lowprocess/carrier/bak/carrier.kicad_pcb

## KiCad design bak/carrier.kicad_pcb (2026-10-01)

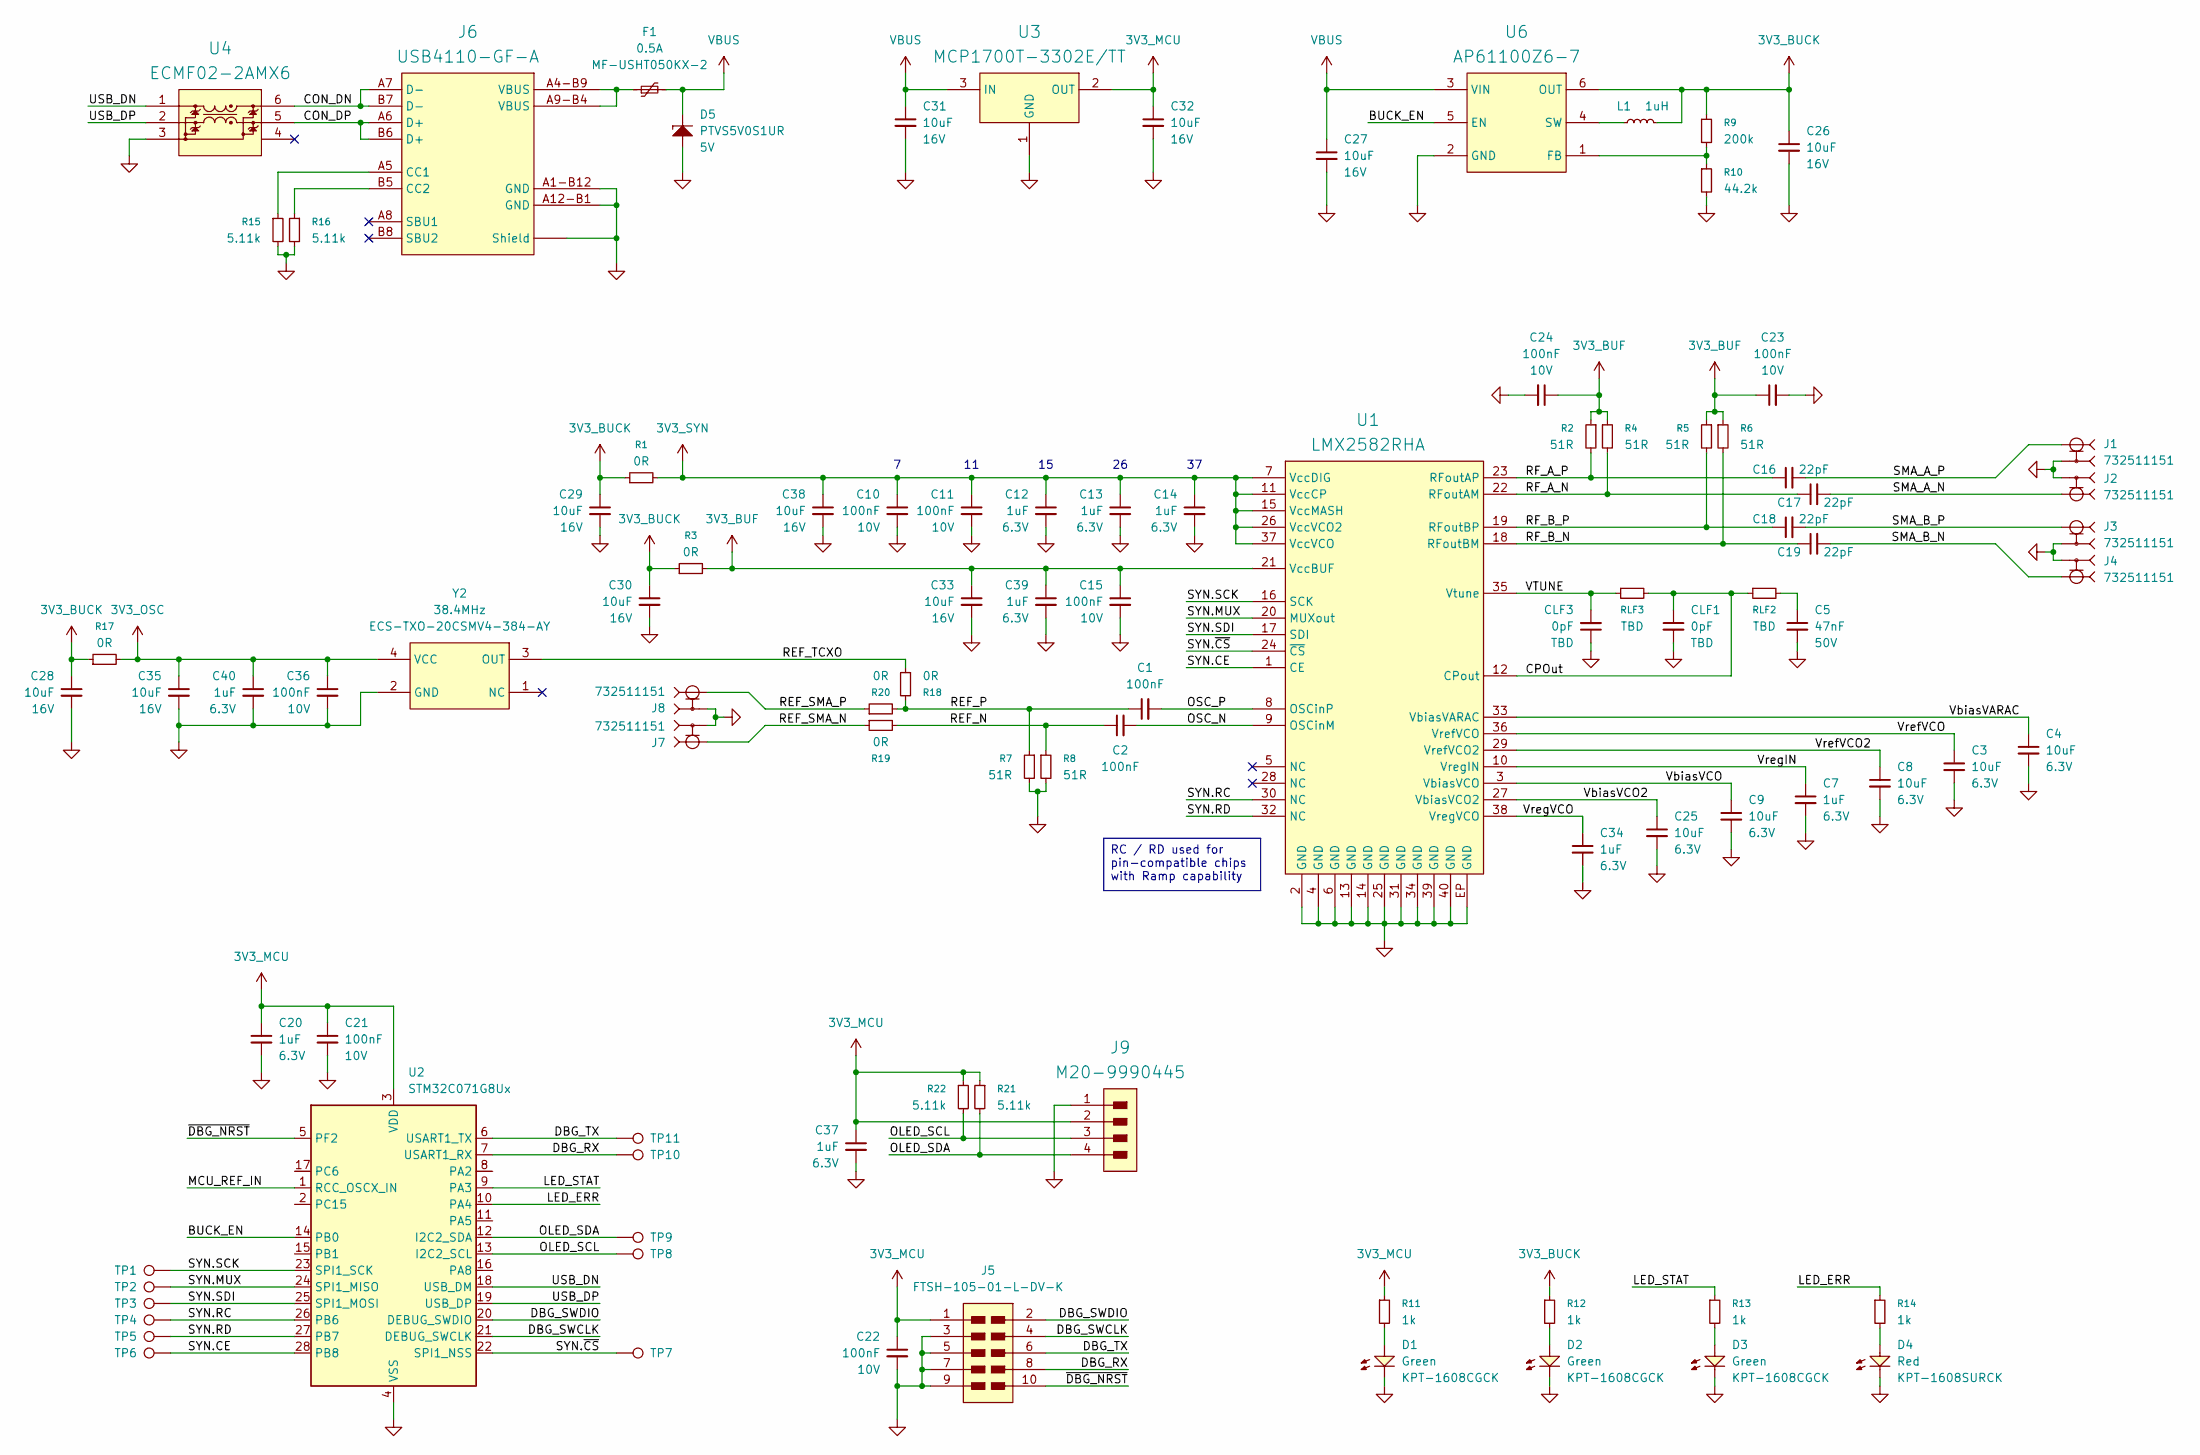
[picture p1: schematic carrier.kicad_sch]

Parts:
C1, C2, C10, C11, C15, C21, C22, C23, C24, C36: 100nF; C_0402; Tolerance 10%; Voltage 10V; PartNumber GRM155R71A104K
C3, C4, C8, C9, C25: 10uF; C_0402; Tolerance 20%; Voltage 6.3V; PartNumber GRM155R60J106M
C5: 47nF; C_1206; Tolerance 5%; Voltage 50V; PartNumber C1206C473J5GACTU
C7, C12, C13, C14, C20, C34, C37, C39, C40: 1uF; C_0402; Tolerance 10%; Voltage 6.3V; PartNumber GRM155R70J105K
C16, C17, C18, C19: 22pF; C_0201; Tolerance 5%; Voltage 25V; PartNumber GRM0335C1E220J
C26, C27, C28, C29, C30, C31, C32, C33, C35, C38: 10uF; C_0805; Tolerance 10%; Voltage 16V; PartNumber GRM21BR61C106K
CLF1, CLF3: 0pF; C_0402; Tolerance TBD; Voltage TBD; PartNumber 0402_TBD
D1, D2, D3: Green; LED_0603; PartNumber KPT-1608CGCK
D4: Red; LED_0603; PartNumber KPT-1608SURCK
D5: SOD123W; PartNumber PTVS5V0S1UR
F1: 0.5A; F_1210; PartNumber MF-USHT050KX-2
J1, J2, J3, J4, J7, J8: 732511151; Molex 73251-1151; PartNumber 732511151
J5: FTSH-105-01-L-DV-K; FTSH-105-01-X-DV-K; PartNumber FTSH-105-01-L-DV-K
J6: USB4110-GF-A; USB-C USB4110; PartNumber USB4110-GF-A
J9: M20-9990445; Header 2.54 1x04 Staggered; PartNumber M20-9990445
L1: 1uH; L_252010; Tolerance 20%; PartNumber CIGT252010EH1R0MNE
R1, R3, R17, R18, R19, R20: 0R; R_0402; Tolerance 0%; PartNumber CRCW04020000Z0ED
R2, R4, R5, R6, R7, R8: 51R; R_0201; Tolerance 1%; PartNumber CRCW020151R0FNED
R9: 200k; R_0402; Tolerance 1%; PartNumber RC0402FR-07200KL
R10: 44.2k; R_0402; Tolerance 1%; PartNumber RC0402FR-0744K2L
R11, R12, R13, R14: 1k; R_0402; Tolerance 1%; PartNumber CRCW04021K00FKED
R15, R16, R21, R22: 5.11k; R_0402; Tolerance 1%; PartNumber RC0402FR-075K11L
RLF2, RLF3: TBD; R_0402; Tolerance TBD; PartNumber 0402_TBD
TP1: SCK; Testpad_1mm
TP2: MUX; Testpad_1mm
TP3: SDI; Testpad_1mm
TP4: RC; Testpad_1mm
TP5: RD; Testpad_1mm
TP6: CE; Testpad_1mm
TP7: CS; Testpad_1mm
TP8: SCL; Testpad_1mm
TP9, TP10, TP11: SDA; Testpad_1mm
U1: QFN40; PartNumber LMX2582RHA
U2: STM32C071G8Ux; QFN-28_4x4mm_P0.5mm
U3: SOT-23-3; PartNumber MCP1700T-3302E/TT
U4: DFN6-1.55x1.75; PartNumber ECMF02-2AMX6
U6: SOT563; PartNumber AP61100Z6-7
Y2: 38.4MHz; XTAL2016-4; PartNumber ECS-TXO-20CSMV4-384-AY

Connections:
3V3_BUCK: C26.1, C28.1, C29.1, C30.1, L1.2, R1.1, R3.1, R9.1, R12.1, R17.1, U6.6 (OUT)
3V3_BUF: C15.1, C23.1, C24.1, C33.1, C39.1, R2.1, R3.2, R4.1, R5.1, R6.1, U1.21 (VccBUF)
3V3_MCU: C20.1, C21.1, C22.1, C32.1, C37.1, J5.1, J9.2, R11.1, R21.1, R22.1, U2.3 (VDD), U3.2 (OUT)
3V3_OSC: C35.1, C36.1, C40.1, R17.2, Y2.4 (VCC)
3V3_SYN: C10.1, C11.1, C12.1, C13.1, C14.1, C38.1, R1.2, U1.7 (VccDIG), U1.11 (VccCP), U1.15 (VccMASH), U1.26 (VccVCO2), U1.37 (VccVCO)
/BUCK_EN: U2.14 (PB0), U6.5 (EN)
/CON_DN: J6.A7 (D-), J6.B7 (D-), U4.6 (IC+)
/CON_DP: J6.A6 (D+), J6.B6 (D+), U4.5 (IC-)
/CPOut: CLF1.1, RLF2.1, RLF3.2, U1.12 (CPout)
/DBG_RX: J5.8, TP10.1 (1_1), U2.7 (USART1_RX)
/DBG_SWCLK: J5.4, U2.21 (DEBUG_SWCLK)
/DBG_SWDIO: J5.2, U2.20 (DEBUG_SWDIO)
/DBG_TX: J5.6, TP11.1 (1_1), U2.6 (USART1_TX)
/LED_ERR: R14.1, U2.10 (PA4)
/LED_STAT: R13.1, U2.9 (PA3)
/MCU_REF_IN: U2.1 (RCC_OSCX_IN)
/OLED_SCL: J9.3, R22.2, TP8.1 (1_1), U2.13 (I2C2_SCL)
/OLED_SDA: J9.4, R21.2, TP9.1 (1_1), U2.12 (I2C2_SDA)
/OSC_N: C2.2, U1.9 (OSCinM)
/OSC_P: C1.2, U1.8 (OSCinP)
/REF_N: C2.1, R8.1, R19.2
/REF_P: C1.1, R7.1, R18.2, R20.2
/REF_SMA_N: J7.inner (Inner), R19.1
/REF_SMA_P: J8.inner (Inner), R20.1
/REF_TCXO: R18.1, Y2.3 (OUT)
/RF_A_N: C17.1, R4.2, U1.22 (RFoutAM)
/RF_A_P: C16.1, R2.2, U1.23 (RFoutAP)
/RF_B_N: C19.1, R6.2, U1.18 (RFoutBM)
/RF_B_P: C18.1, R5.2, U1.19 (RFoutBP)
/SMA_A_N: C17.2, J2.inner (Inner)
/SMA_A_P: C16.2, J1.inner (Inner)
/SMA_B_N: C19.2, J4.inner (Inner)
/SMA_B_P: C18.2, J3.inner (Inner)
/SYN.CE: TP6.1 (1_1), U1.1 (CE), U2.28 (PB8)
/SYN.MUX: TP2.1 (1_1), U1.20 (MUXout), U2.24 (SPI1_MISO)
/SYN.RC: TP4.1 (1_1), U1.30 (NC), U2.26 (PB6)
/SYN.RD: TP5.1 (1_1), U1.32 (NC), U2.27 (PB7)
/SYN.SCK: TP1.1 (1_1), U1.16 (SCK), U2.23 (SPI1_SCK)
/SYN.SDI: TP3.1 (1_1), U1.17 (SDI), U2.25 (SPI1_MOSI)
/SYN.~CS: TP7.1 (1_1), U1.24 (~CS), U2.22 (SPI1_NSS)
/USB_DN: U2.18 (USB_DM), U4.1 (CON+)
/USB_DP: U2.19 (USB_DP), U4.2 (CON-)
/VTUNE: CLF3.2, RLF3.1, U1.35 (Vtune)
/VbiasVARAC: C4.1, U1.33 (VbiasVARAC)
/VbiasVCO: C9.1, U1.3 (VbiasVCO)
/VbiasVCO2: C25.1, U1.27 (VbiasVCO2)
/VrefVCO: C3.1, U1.36 (VrefVCO)
/VrefVCO2: C8.1, U1.29 (VrefVCO2)
/VregIN: C7.1, U1.10 (VregIN)
/VregVCO: C34.1, U1.38 (VregVCO)
/~DBG_NRST: J5.10, U2.5 (PF2)
GND: C3.2, C4.2, C5.2, C7.2, C8.2, C9.2, C10.2, C11.2, C12.2, C13.2, C14.2, C15.2, C20.2, C21.2, C22.2, C23.2, C24.2, C25.2, C26.2, C27.2, C28.2, C29.2, C30.2, C31.2, C32.2, C33.2, C34.2, C35.2, C36.2, C37.2, C38.2, C39.2, C40.2, CLF1.2, CLF3.1, D1.K, D2.K, D3.K, D4.K, D5.A, J1.outer (Outer), J2.outer (Outer), J3.outer (Outer), J4.outer (Outer), J5.3, J5.5, J5.7, J5.9, J6.A1-B12 (GND), J6.A12-B1 (GND), J6.SH (Shield), J7.outer (Outer), J8.outer (Outer), J9.1, R7.2, R8.2, R10.2, R15.2, R16.2, U1.2 (GND), U1.4 (GND), U1.6 (GND), U1.13 (GND), U1.14 (GND), U1.25 (GND), U1.31 (GND), U1.34 (GND), U1.39 (GND), U1.40 (GND), U1.EP (GND), U2.4 (VSS), U3.1 (GND), U4.3 (GND), U6.2 (GND), Y2.2 (GND); also elsewhere on the board
unnamed 52: C5.1, RLF2.2; also elsewhere on the board
unnamed: D1.A, R11.2
unnamed: D2.A, R12.2
unnamed: D3.A, R13.2
unnamed: D4.A, R14.2
unnamed: F1.1, J6.A4-B9 (VBUS), J6.A9-B4 (VBUS)
unnamed: J6.A5 (CC1), R15.1
unnamed: J6.B5 (CC2), R16.1
unnamed: R9.2, R10.1, U6.1 (FB)
unnamed: L1.1, U6.4 (SW)
VBUS: C27.1, C31.1, D5.K, F1.2, U3.3 (IN), U6.3 (VIN)

Notes on the sheet:
RC / RD used for pin-compatible chips with Ramp capability

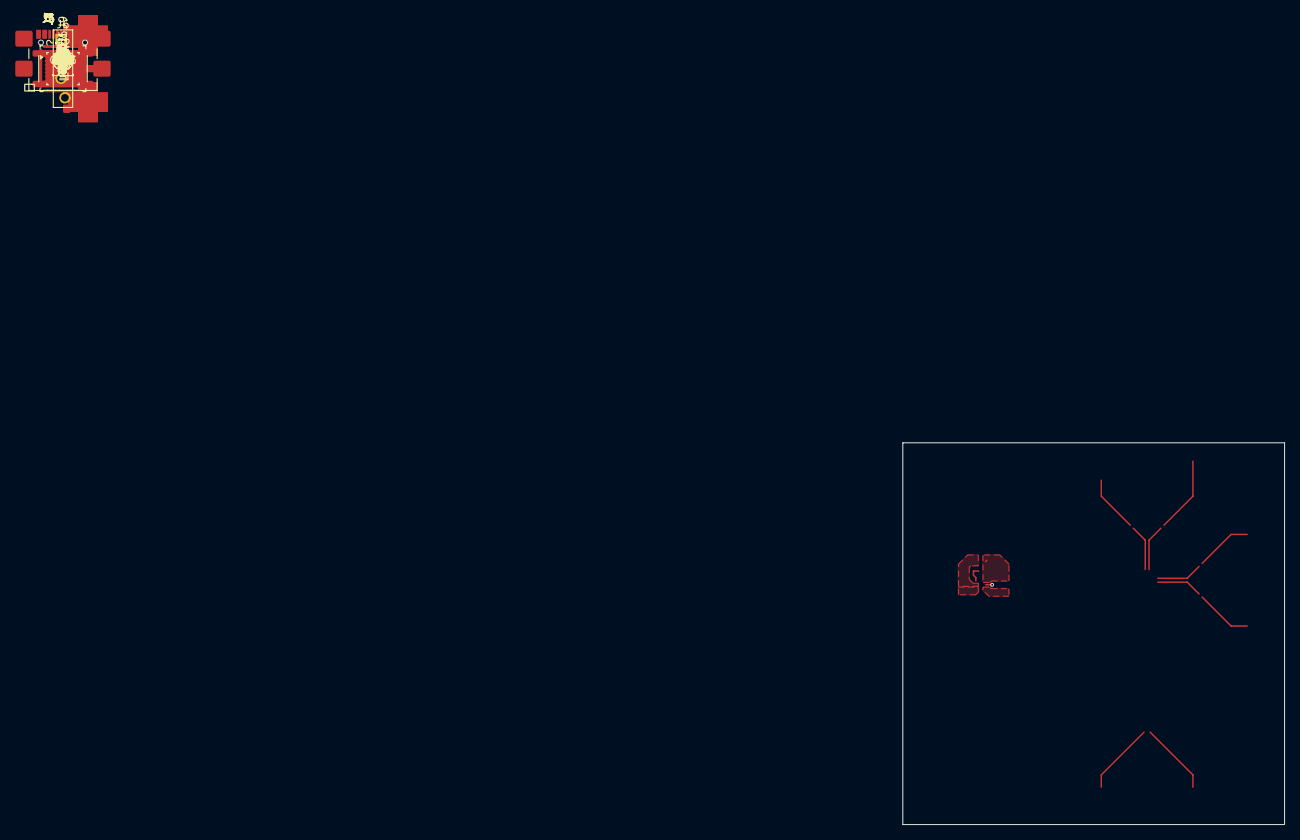
[picture p2: board bak/carrier.kicad_pcb from above]

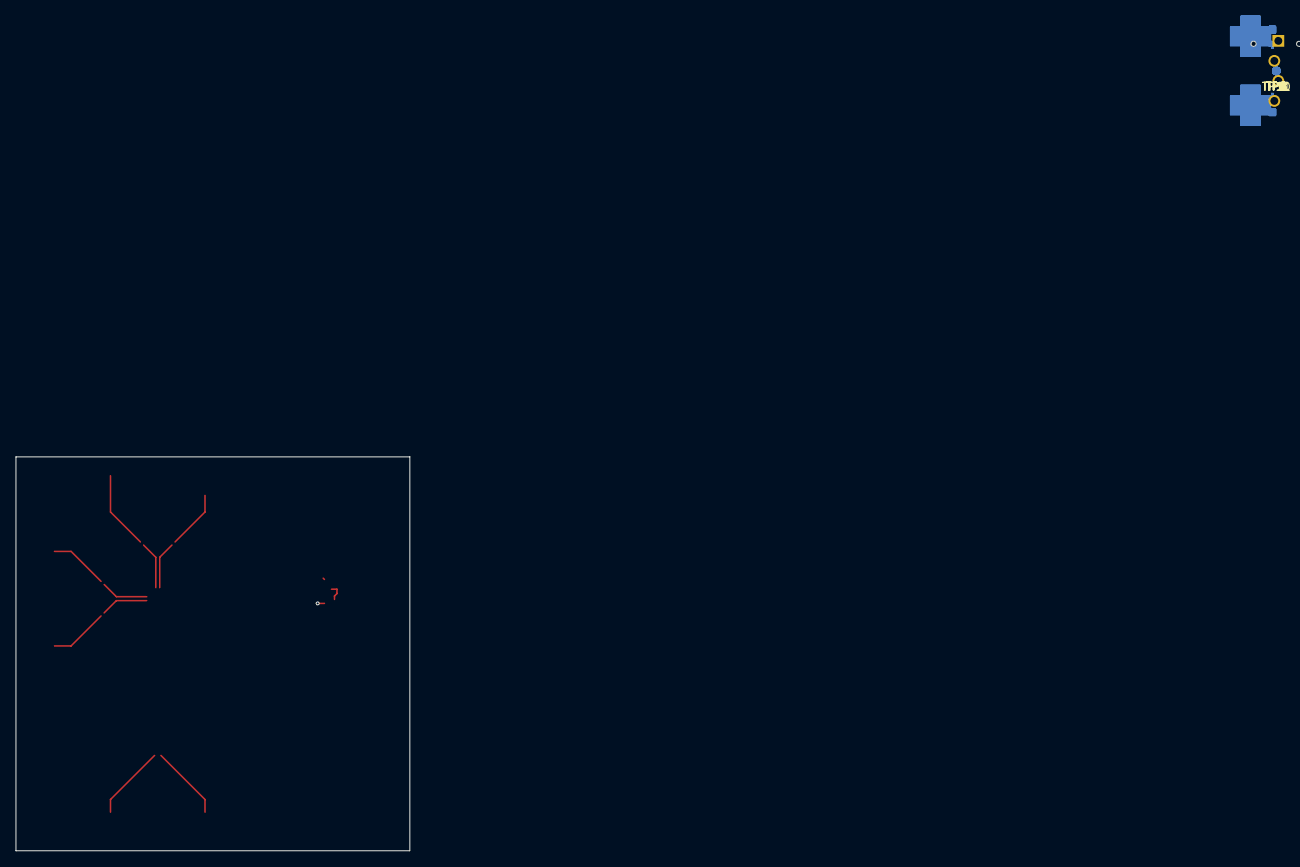
[picture p3: board bak/carrier.kicad_pcb from below]

Board: 2 copper layers, 50.0 x 50.0 mm, 98 parts (11 on the bottom side), 62 nets.

Other parts of the board:
CLF2: 0pF; C_0402

Their connections:
GND: CLF2.2; also elsewhere on the board
unnamed 52: CLF2.1; also elsewhere on the board
