lowprocess/carrier/carrier.kicad_pcb

## KiCad design carrier.kicad_pcb (2026-10-01)

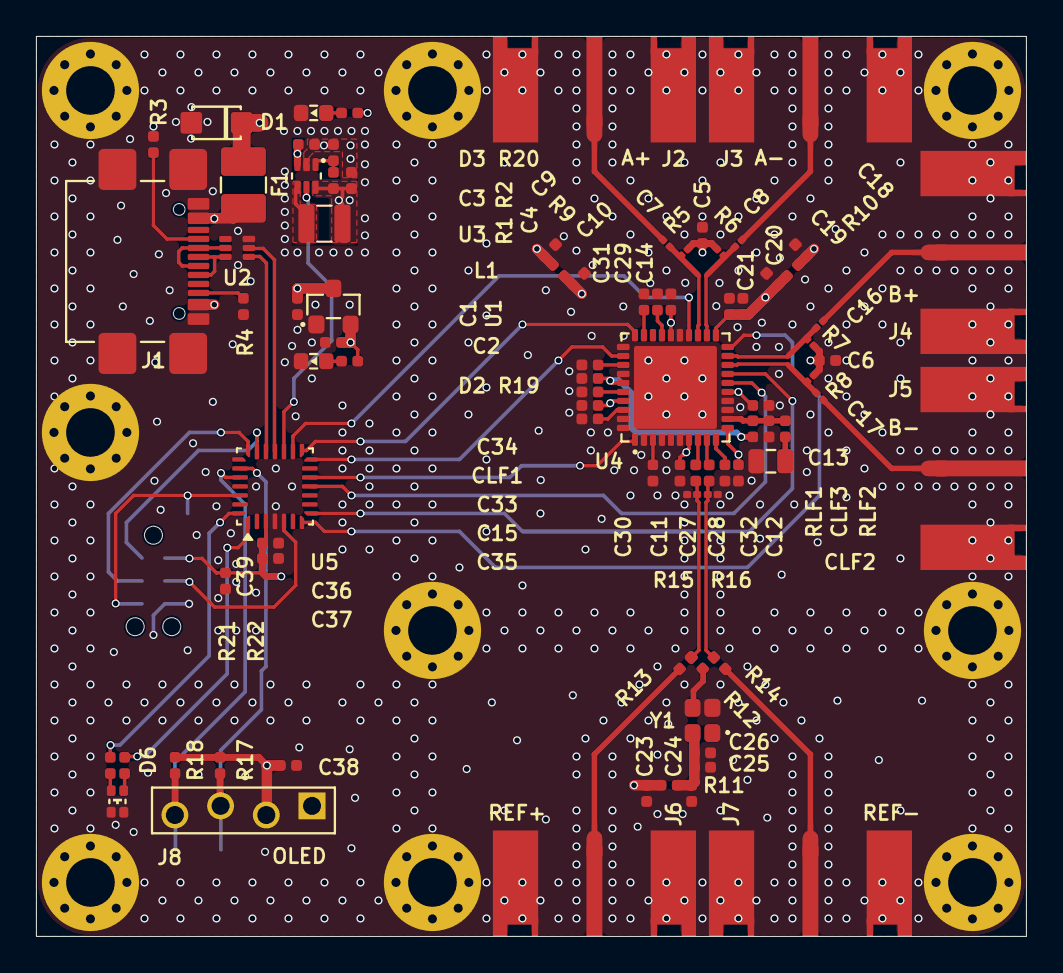
[picture p4: board carrier.kicad_pcb from above]

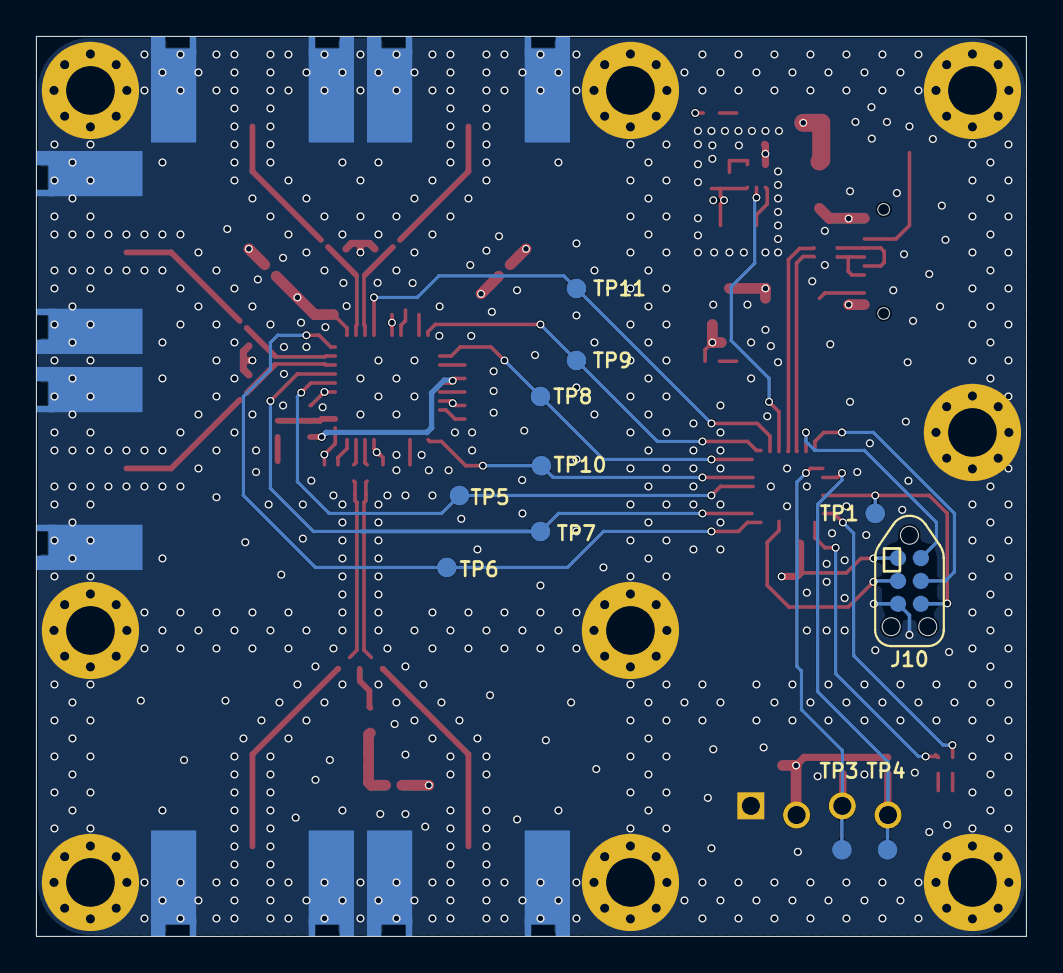
[picture p5: board carrier.kicad_pcb from below]

Board: 4 copper layers, 55.0 x 50.0 mm, 105 parts (11 on the bottom side), 61 nets.

Parts:
C1, C2, C3, C4, C9, C10, C18, C19, C23, C24, C29, C30, C31, C33, C34: 10uF; C_0402
C5, C6, C11, C12, C21, C26, C27, C28, C37, C39: 100nF; C_0402
C7, C8, C16, C17: 22pF; C_0201
C13, C14, C15, C20, C25, C32, C35, C36, C38: 1uF; C_0402
CLF1, CLF3: 0pF; C_0402
CLF2: 10nF; C_0805
D1: SOD123W
D2, D3: Green; LED_0603
D6: RG; APHB1608GR
F1: 0.5A; F_1210
H1, H2, H3, H4, H5, H6, H7, H8, H9: GND; MountingHole_2.7mm_M2.5_Pad_Via
J1: USB4110-GF-A; USB-C USB4110
J2, J3, J4, J5, J6, J7: 732511151; Molex 73251-1151
J8: M20-9990445; Header 2.54 1x04 Staggered
J10: TC2030-NL-FP; TC2030-xxx-NL
L1: 1uH; L_252010
R1: 200k; R_0402
R2: 44.2k; R_0402
R3, R4, R17, R18: 5.11k; R_0402
R5, R6, R7, R8, R15, R16: 51R; R_0201
R9, R10, R11, R12, R13, R14: 0R; R_0402
R19, R20, R21, R22: 1k; R_0402
RLF1, RLF2: TBD; R_0402
TP1, TP3: SDA; Testpad_1mm
TP4: SCL; Testpad_1mm
TP5: SCK; Testpad_1mm
TP6: MUX; Testpad_1mm
TP7: SDI; Testpad_1mm
TP8: RC; Testpad_1mm
TP9: RD; Testpad_1mm
TP10: CE; Testpad_1mm
TP11: CS; Testpad_1mm
U1: SOT-23-3
U2: DFN6-1.55x1.75
U3: SOT563
U4: QFN40
U5: STM32C071G8Ux; QFN-28_4x4mm_P0.5mm
Y1: 38.4MHz; XTAL2016-4

Connections:
3V3_BUCK: C4.1, C9.1, C18.1, L1.2, R1.1, R9.1, R10.1, R20.1, U3.6 (OUT)
3V3_BUF: C5.1, C6.1, C19.1, C20.1, C21.1, R5.1, R6.1, R7.1, R8.1, R10.2, U4.21 (VccBUF)
3V3_MCU: C2.1, C23.1, C36.1, C37.1, C38.1, C39.1, J8.2, J10.1, R11.1, R17.1, R18.1, R19.1, U1.2 (OUT), U5.3 (VDD)
3V3_OSC: C24.1, C25.1, C26.1, R11.2, Y1.4 (VCC)
3V3_SYN: C10.1, C11.1, C12.1, C13.1, C14.1, C15.1, R9.2, U4.7 (VccDIG), U4.11 (VccCP), U4.15 (VccMASH), U4.26 (VccVCO2), U4.37 (VccVCO)
/BUCK_EN: U3.5 (EN), U5.17 (PC6)
/CON_DN: J1.A7 (D-), J1.B7 (D-), U2.5 (IC-)
/CON_DP: J1.A6 (D+), J1.B6 (D+), U2.6 (IC+)
/CPOut: CLF3.1, RLF1.2, RLF2.1, U4.12 (CPout)
/DBG_SWCLK: J10.4, U5.21 (DEBUG_SWCLK)
/DBG_SWDIO: J10.2, U5.20 (DEBUG_SWDIO)
/DBG_TX: J10.6, TP1.1 (1_1), U5.26 (USART1_TX)
/LED_ERR: R22.1, U5.1 (PC14)
/LED_STAT: R21.1, U5.28 (PB8)
/OLED_SCL: J8.3, R17.2, TP3.1 (1_1), U5.23 (I2C2_SCL)
/OLED_SDA: J8.4, R18.2, TP4.1 (1_1), U5.24 (I2C2_SDA)
/OSC_N: C28.2, U4.9 (OSCinM)
/OSC_P: C27.2, U4.8 (OSCinP)
/REF_N: C28.1, R14.2, R16.1
/REF_P: C27.1, R12.2, R13.2, R15.1
/REF_SMA_N: J7.inner (Inner), R14.1
/REF_SMA_P: J6.inner (Inner), R13.1
/REF_TCXO: R12.1, Y1.3 (OUT)
/RF_A_N: C8.1, R6.2, U4.22 (RFoutAM)
/RF_A_P: C7.1, R5.2, U4.23 (RFoutAP)
/RF_B_N: C17.1, R8.2, U4.18 (RFoutBM)
/RF_B_P: C16.1, R7.2, U4.19 (RFoutBP)
/SMA_A_N: C8.2, J3.inner (Inner)
/SMA_A_P: C7.2, J2.inner (Inner)
/SMA_B_N: C17.2, J5.inner (Inner)
/SMA_B_P: C16.2, J4.inner (Inner)
/SYN.CE: TP10.1 (1_1), U4.1 (CE), U5.12 (PA6)
/SYN.MUX: TP6.1 (1_1), U4.20 (MUXout), U5.7 (PA1)
/SYN.RC: TP9.1 (1_1), U4.30 (NC), U5.15 (PB1)
/SYN.RD: TP8.1 (1_1), U4.32 (NC), U5.14 (PB0)
/SYN.SCK: TP5.1 (1_1), U4.16 (SCK), U5.11 (SPI1_SCK)
/SYN.SDI: TP7.1 (1_1), U4.17 (SDI), U5.8 (SPI1_MOSI)
/SYN.~CS: TP11.1 (1_1), U4.24 (~CS), U5.16 (PA8)
/USB_DN: U2.2 (CON-), U5.18 (USB_DM)
/USB_DP: U2.1 (CON+), U5.19 (USB_DP)
/VTUNE: CLF1.2, RLF1.1, U4.35 (Vtune)
/VbiasVARAC: C34.1, U4.33 (VbiasVARAC)
/VbiasVCO: C30.1, U4.3 (VbiasVCO)
/VbiasVCO2: C29.1, U4.27 (VbiasVCO2)
/VrefVCO: C33.1, U4.36 (VrefVCO)
/VrefVCO2: C31.1, U4.29 (VrefVCO2)
/VregIN: C32.1, U4.10 (VregIN)
/VregVCO: C35.1, U4.38 (VregVCO)
/~DBG_NRST: J10.3, U5.5 (PF2)
GND: C1.2, C2.2, C3.2, C4.2, C5.2, C6.2, C9.2, C10.2, C11.2, C12.2, C13.2, C14.2, C15.2, C18.2, C19.2, C20.2, C21.2, C23.2, C24.2, C25.2, C26.2, C29.2, C30.2, C31.2, C32.2, C33.2, C34.2, C35.2, C36.2, C37.2, C38.2, C39.2, CLF1.1, CLF2.2, CLF3.2, D1.A, D2.K, D3.K, D6.GK (Green_K), D6.RK (Red_K), H1.1 (1_1), H2.1 (1_1), H3.1 (1_1), H4.1 (1_1), H5.1 (1_1), H6.1 (1_1), H7.1 (1_1), H8.1 (1_1), H9.1 (1_1), J1.A1-B12 (GND), J1.A12-B1 (GND), J1.SH (Shield), J2.outer (Outer), J3.outer (Outer), J4.outer (Outer), J5.outer (Outer), J6.outer (Outer), J7.outer (Outer), J8.1, J10.5, R2.2, R3.2, R4.2, R15.2, R16.2, U1.1 (GND), U2.3 (GND), U3.2 (GND), U4.2 (GND), U4.4 (GND), U4.6 (GND), U4.13 (GND), U4.14 (GND), U4.25 (GND), U4.31 (GND), U4.34 (GND), U4.39 (GND), U4.40 (GND), U4.EP (GND), U5.4 (VSS), Y1.2 (GND)
unnamed: CLF2.1, RLF2.2
unnamed: D2.A, R19.2
unnamed: D3.A, R20.2
unnamed: D6.RA (Red_A), R21.2
unnamed: D6.GA (Green_A), R22.2
unnamed: F1.1, J1.A4-B9 (VBUS), J1.A9-B4 (VBUS)
unnamed: J1.A5 (CC1), R3.1
unnamed: J1.B5 (CC2), R4.1
unnamed: R1.2, R2.1, U3.1 (FB)
unnamed: L1.1, U3.4 (SW)
VBUS: C1.1, C3.1, D1.K, F1.2, U1.3 (IN), U3.3 (VIN)
