lowprocess/carrier/(commit log)

2026-09-23 first commit for carrier experimental synth boards
    [carrier.kicad_pcb, carrier.kicad_sch]
2026-09-27 schematic complete
    [carrier.kicad_pcb, carrier.kicad_sch]
2026-10-01 layout complete
    [carrier.kicad_pcb, carrier.kicad_sch]
